frankzhangxinzhi/biomimetic-robotic-octopus/README.md

# Biomimetic Robotic Octopus

A biomimetic underwater robot using asymmetrically stiffening flexible fins for propulsion and maneuvering.

<p align="center">
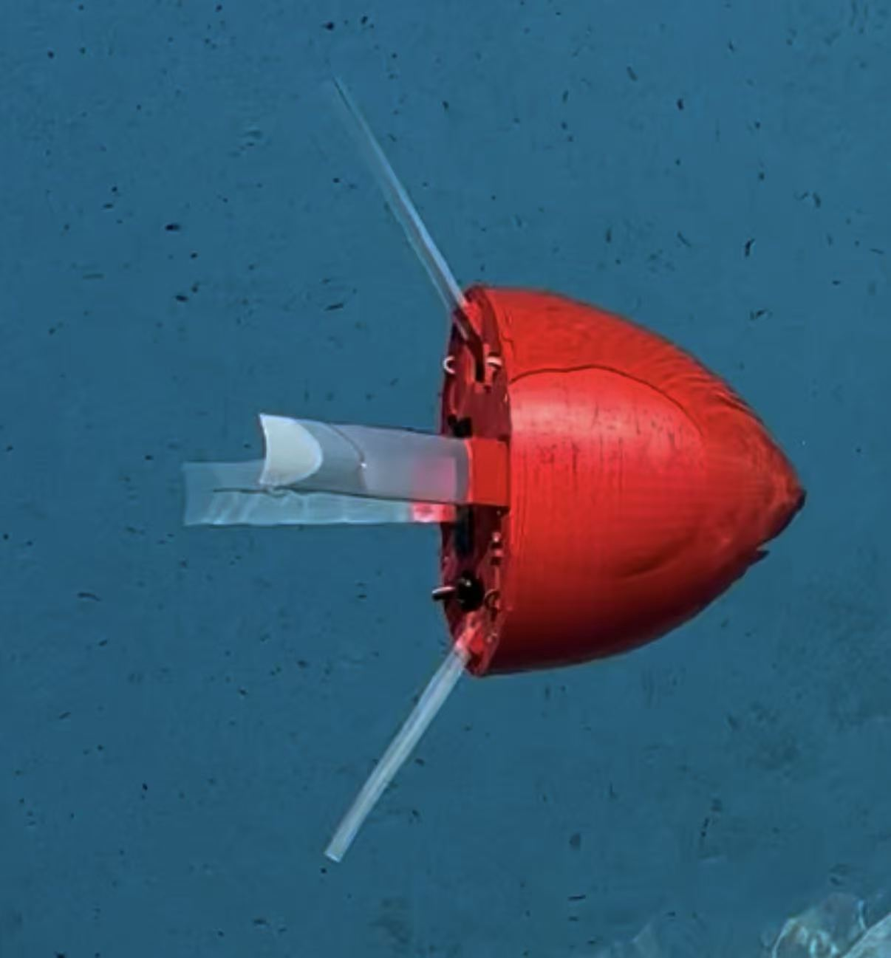
[picture p1: images/robot-pool-test.jpg]
Biomimetic robotic octopus during pool testing
  
</p>

## Overview

This project was developed by a three-person USC engineering team to design, manufacture, and test a compact biomimetic underwater robot. Four servo-actuated flexible fins use asymmetric stiffening to generate propulsion.

Pool trials demonstrated fin-driven propulsion and a basic turning response. The report extrapolated fitted swimming trajectories to assess stability over 3 m of travel. Three fin-deactivation trials reported a 180-degree turning response of 5.5 ± 0.4 seconds. Closed-loop heading control and trajectory tracking remained future work.

## Explore the Project

| Project area | Files and documentation |
| --- | --- |
| AME 441a: fin characterization | [Original MATLAB analysis, dual-servo firmware and experimental data](research/fin-characterization) |
| AME 441b: mechanical design | [SolidWorks assembly and STEP model](hardware/mechanical) |
| AME 441b: electronics | [KiCad schematic, PCB layout and connector mapping](hardware/pcb) |
| AME 441b: robot firmware | [Four-servo BLE control and operating sequence](software/firmware/robot_control_ble) |
| AME 441b: pool testing | [Swimming and turning results, figures and recovered Tracker files](testing/pool-tests) |

## My Contributions

- Independently designed the custom PCB in KiCad and completed system wiring and circuit debugging.
- Led the SolidWorks mechanical design and independently performed the buoyancy calculations.
- Collaborated on IMU data acquisition and MATLAB-based data visualization.
- Independently completed waterproofing integration and electrical system validation.
- Co-developed the Arduino-based control software for four servo-actuated fins.
- Led pool testing and analysis of straight-swimming and turning performance.

## Earlier Research Phase: AME 441a

Before the robotic octopus integration, the first semester investigated tunable-stiffness fins using a load-cell water-tank test fixture. Four materials and multiple fin lengths were evaluated through MATLAB data acquisition and analysis. Nylon reached a measured thrust-to-drag ratio of approximately 2.70 at 125 mm.

[View the recovered Arduino firmware, original MATLAB code, saved results, experiment documentation and data inventory.](research/fin-characterization)

[Download the AME 441a experimental data archive (156 CSV files).](https://github.com/frankzhangxinzhi/biomimetic-robotic-octopus/releases/tag/441a-data-v1)

This earlier four-person research phase is documented separately from the three-person AME 441b robot described on this page.

## System Design

<p align="center">
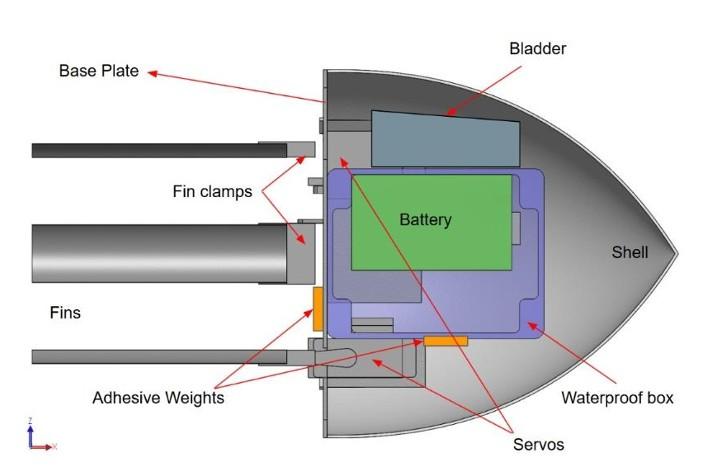
[picture p2: images/system-cross-section.jpg]
Cross-sectional SolidWorks model of the robotic octopus
  
</p>

<p align="center"><em>Cross-sectional SolidWorks model showing the mechanical and electrical system layout.</em></p>

[View the complete SolidWorks source assembly and neutral STEP model.](hardware/mechanical)

### Mechanical Architecture

- Overall vehicle length: 320 mm, including the flexible fins.
- Base plate diameter: 200 mm.
- SolidWorks mass-property and buoyancy models were used to position the center of buoyancy approximately 14 mm above the center of mass for passive restoring stability.
- Four servo-actuated flexible fins generate thrust through asymmetric stiffening and buckling.

### Electrical and Control System

- Arduino Nano RP2040 Connect with an onboard IMU for orientation sensing.
- Four high-torque servo motors actuate the flexible fins.
- Custom PCB designed in KiCad to fit inside the limited waterproof enclosure.
- PCB power traces use a 2 mm width designed to carry at least 4 A.
- Two 7.2 V Ni-MH battery packs divide the electrical load between the Arduino and four servos.
- Electronics are housed inside an IP67-rated junction box with sealed cable penetrations.

## Testing and Results

Pool testing was recorded using multiple GoPro cameras. The robot's position was manually tracked in Physics Tracker and exported for trajectory analysis.

- Conducted pool-swimming trials and used fitted motion trends to estimate performance over 3 m of travel.
- The report projected vertical displacement of 0.44-0.79 m over 3 m of travel, demonstrating the need for active stability control. This range was extrapolated from fitted motion trends.
- Characterized the open-loop turning response by deactivating one fin: a 180-degree reorientation took 5.5 ± 0.4 seconds across three trials.
- IMU acceleration and gyroscope data were evaluated for future pitch, roll, and yaw feedback control.

The turning trials demonstrated a basic response to asymmetric fin actuation. Precise commanded-heading control, closed-loop stabilization, and trajectory tracking were not implemented. Testing was limited to three trials per swimming method, and only the 1:1 recovery-to-power-stroke time ratio was tested.

[View the swimming/turning test methods, reported figures and recovered Tracker projects.](testing/pool-tests)

## Engineering Lessons

- Manufacturer-rated waterproof components should be independently pressure- or immersion-tested before system integration.
- PCB trace width must be determined from the maximum expected current before completing the layout.
- Passive buoyancy and mass distribution improve stability but are not sufficient to reject disturbances during swimming.
- IMU-based closed-loop control could vary individual fin actuation to correct trajectory deviations.

## Tools and Technologies

- **Mechanical:** SolidWorks, 3D printing, buoyancy and mass-property analysis
- **Electrical:** KiCad, custom PCB design, Arduino Nano RP2040 Connect, IMU sensing
- **Software and Analysis:** Arduino C/C++, MATLAB, Microsoft Excel, Physics Tracker
- **Testing:** Pool testing, GoPro video capture, trajectory tracking, electrical validation

## Repository Structure

```text
.
├── hardware/
│   ├── mechanical/
│   │   ├── solidworks/               # SolidWorks assembly and referenced part files
│   │   ├── step/                     # Software-independent STEP assembly
│   │   └── README.md                 # Mechanical design documentation
│   └── pcb/                          # KiCad schematic, PCB layout, and project files
├── software/
│   └── firmware/
│       ├── robot_control_ble/        # Arduino BLE servo-control firmware
│       └── archive/                  # Earlier four-servo firmware without BLE
├── research/
│   └── fin-characterization/          # AME 441a original MATLAB work, results, and data inventory
├── testing/
│   └── pool-tests/                    # Swimming/turning methods, report figures, and original Tracker files
├── images/                           # Prototype, CAD, and system-design images
├── .gitignore
└── README.md
```

## Future Work

- Implement closed-loop IMU feedback for pitch, roll, and yaw correction.
- Replace the servos with independently validated waterproof actuators.
- Conduct additional trials across multiple fin frequencies and control inputs.
- Improve trajectory tracking and automate experimental data processing.

## Team

Developed as a three-person USC AME 441b senior design project by Frank Zhang, Adrien Ramos, and Kaleigh Ray.

This repository focuses on Frank Zhang's PCB design, electrical integration, mechanical design, buoyancy analysis, sensing, and testing contributions.
