frankzhangxinzhi/biomimetic-robotic-octopus/testing/pool-tests/figures/reported-3m-horizontal-projection.png

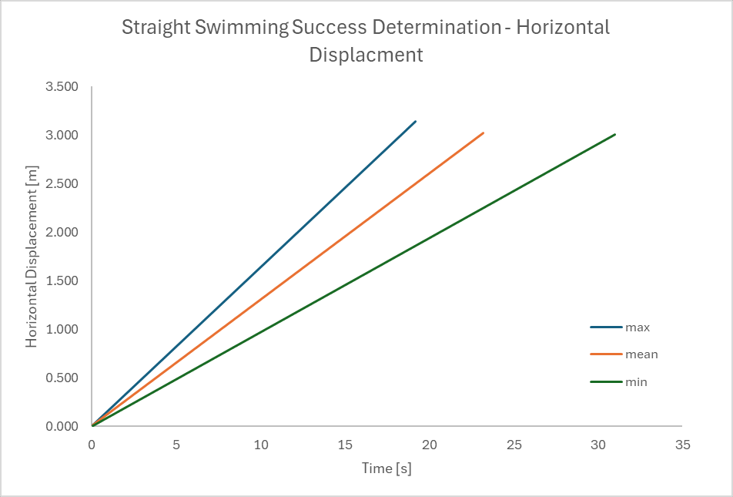
testing/pool-tests/figures/reported-3m-horizontal-projection.png
