frankzhangxinzhi/biomimetic-robotic-octopus/testing/pool-tests/figures/straight-swimming-reported-vertical.png

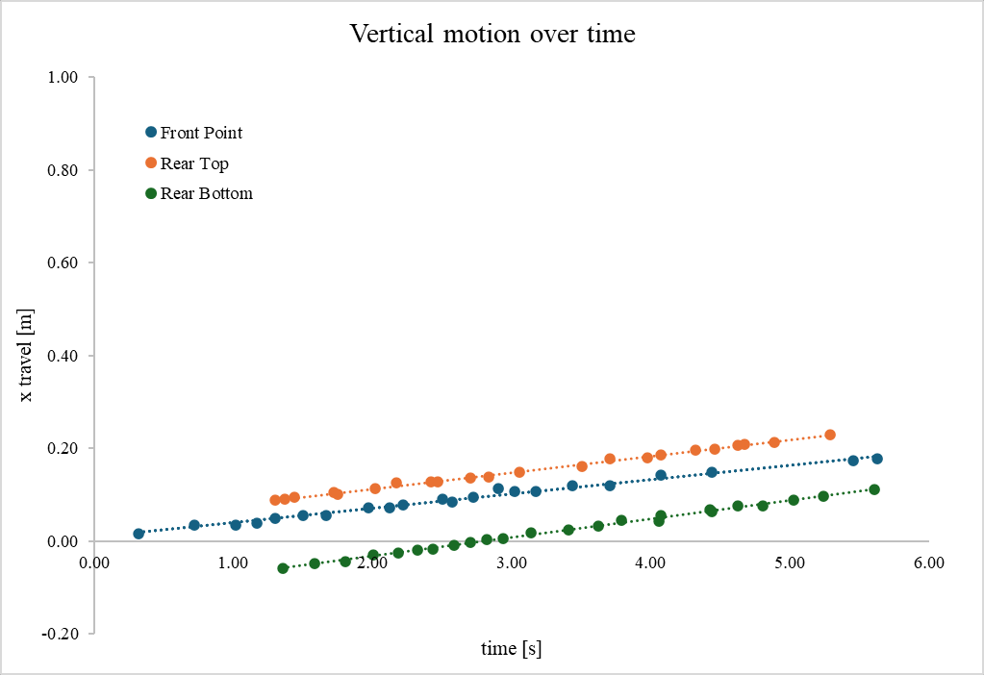
testing/pool-tests/figures/straight-swimming-reported-vertical.png
