frankzhangxinzhi/biomimetic-robotic-octopus/testing/pool-tests/figures/turning-reported-time-trace.png

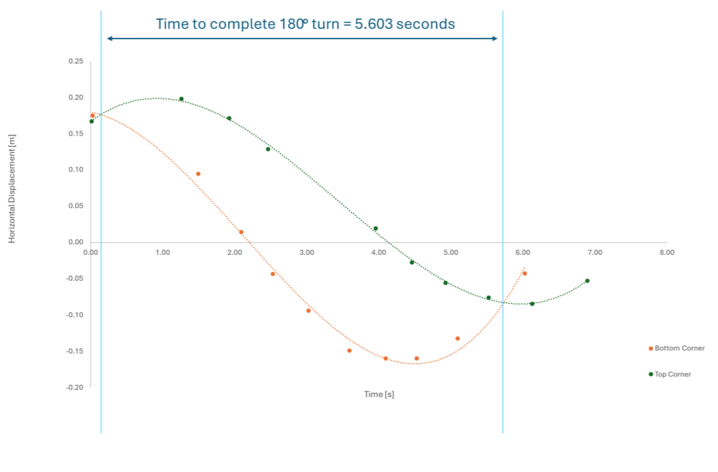
testing/pool-tests/figures/turning-reported-time-trace.png
