frankzhangxinzhi/biomimetic-robotic-octopus/hardware/mechanical/step/RoboOctoV4_Assembly.STEP

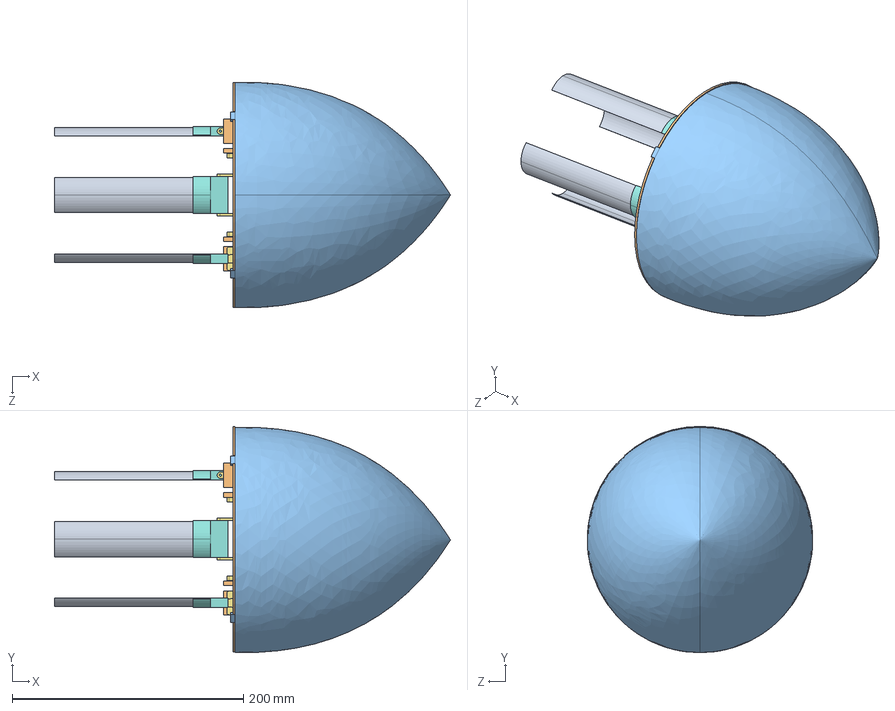
[picture p7: CAD file, 2026-10-29]
hardware/mechanical/step/RoboOctoV4_Assembly.STEP
342.6 x 195.8 x 195.0 mm
BatteryNiMH x 2
ElectroBox115_90_55
converter x 4
wireConnectors
EboxLid
arduinoBlock x 2
servoWithHorn x 4
Clamp x 4
fin x 4
BottomPlate
AdhesiveWeights - Copy (2)
