frankzhangxinzhi/biomimetic-robotic-octopus/hardware/mechanical/solidworks/RoboOctoV4.SLDASM

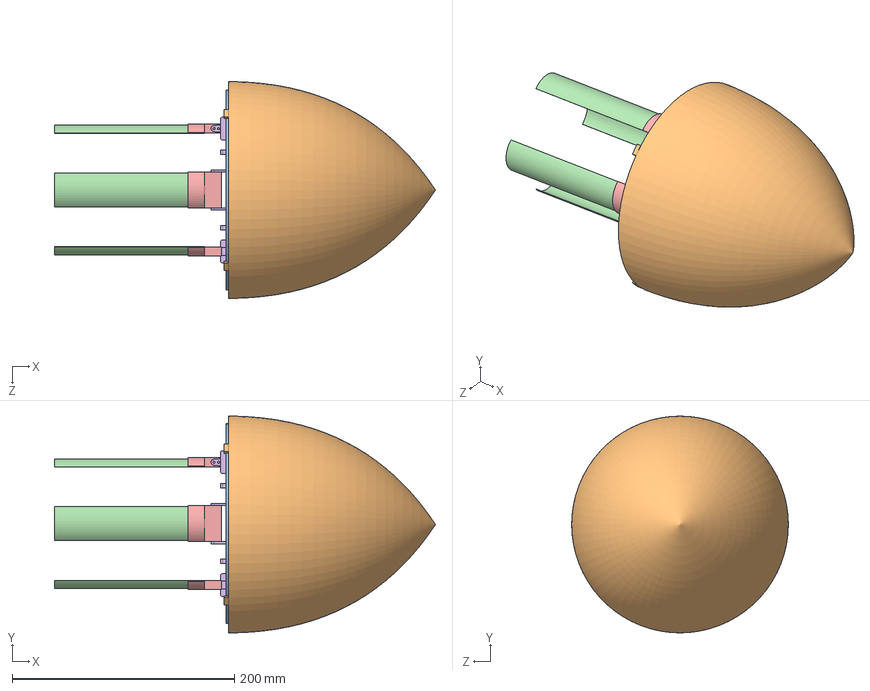
[picture p8: CAD file, 2026-10-29]
hardware/mechanical/solidworks/RoboOctoV4.SLDASM
342.7 x 195.0 x 195.0 mm
BatteryNiMH x 2
ElectroBox115_90_55
converter x 4
wireConnectors
EboxLid
arduinoBlock x 2
servoWithHorn x 4
Clamp x 4
fin x 4
BottomPlate
AdhesiveWeights - Copy (2)
