frankzhangxinzhi/biomimetic-robotic-octopus/hardware/mechanical/solidworks/Assem_electronics.SLDASM

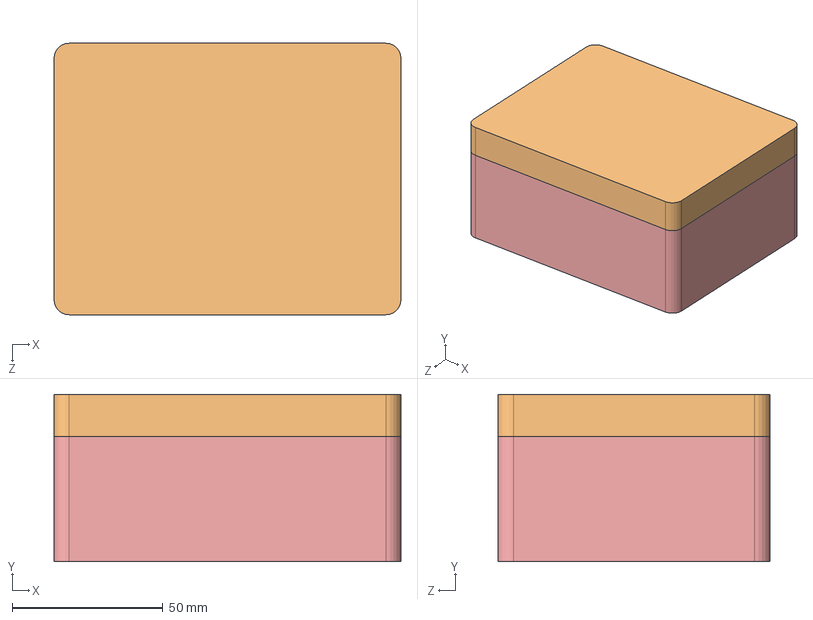
[picture p9: CAD file, 2026-10-29]
hardware/mechanical/solidworks/Assem_electronics.SLDASM
115.0 x 55.5 x 90.0 mm
BatteryNiMH x 2
ElectroBox115_90_55
converter x 4
wireConnectors
EboxLid
arduinoBlock x 2
