frankzhangxinzhi/biomimetic-robotic-octopus/hardware/mechanical/solidworks/servoWithHorn.SLDPRT

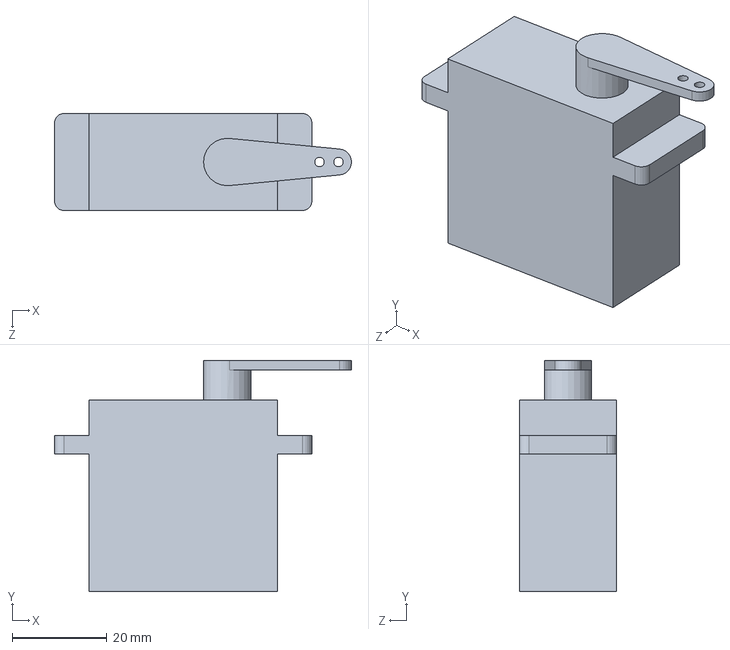
[picture p10: CAD file, 2026-10-29]
hardware/mechanical/solidworks/servoWithHorn.SLDPRT
62.7 x 48.8 x 20.5 mm
