frankzhangxinzhi/biomimetic-robotic-octopus/hardware/mechanical/solidworks/EboxLid.SLDPRT

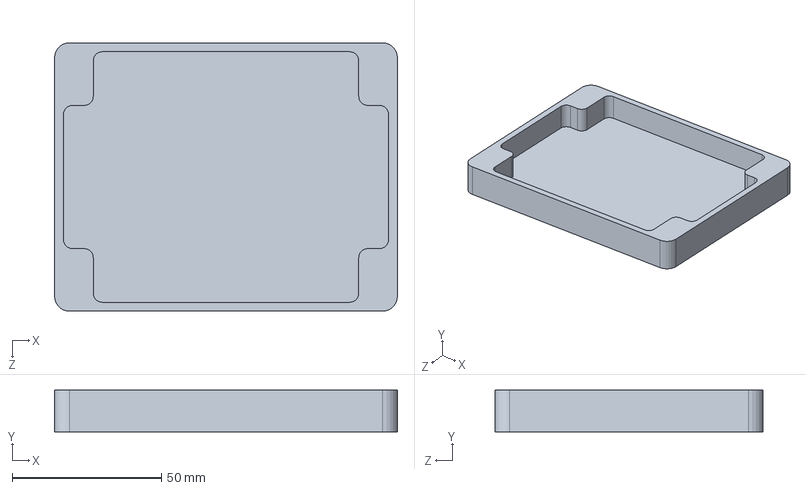
[picture p11: CAD file, 2026-10-29]
hardware/mechanical/solidworks/EboxLid.SLDPRT
115.0 x 14.0 x 90.0 mm
