frankzhangxinzhi/biomimetic-robotic-octopus/hardware/mechanical/solidworks/converter.SLDPRT

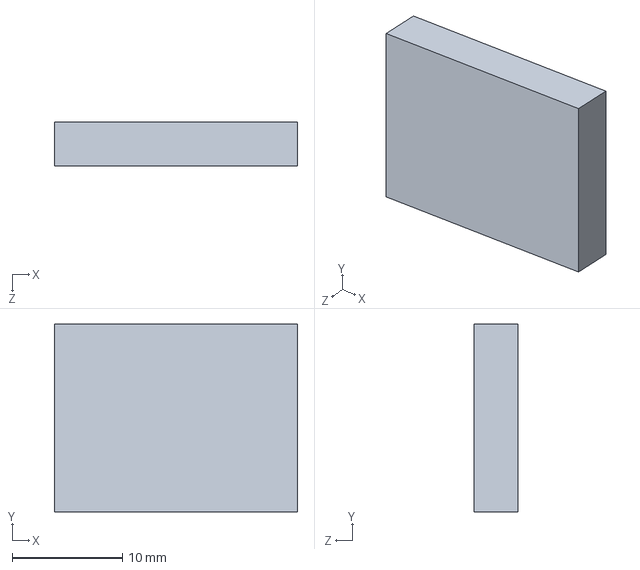
[picture p12: CAD file, 2026-10-29]
hardware/mechanical/solidworks/converter.SLDPRT
22.0 x 17.0 x 4.00 mm
