frankzhangxinzhi/biomimetic-robotic-octopus/hardware/mechanical/solidworks/ElectroBox115_90_55.SLDPRT

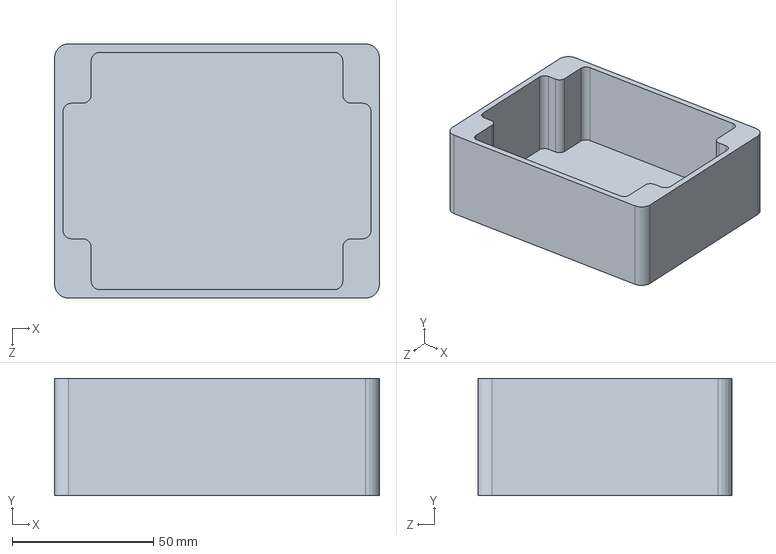
[picture p13: CAD file, 2026-10-29]
hardware/mechanical/solidworks/ElectroBox115_90_55.SLDPRT
115.0 x 41.5 x 90.0 mm
