frankzhangxinzhi/biomimetic-robotic-octopus/hardware/mechanical/solidworks/fin.SLDPRT

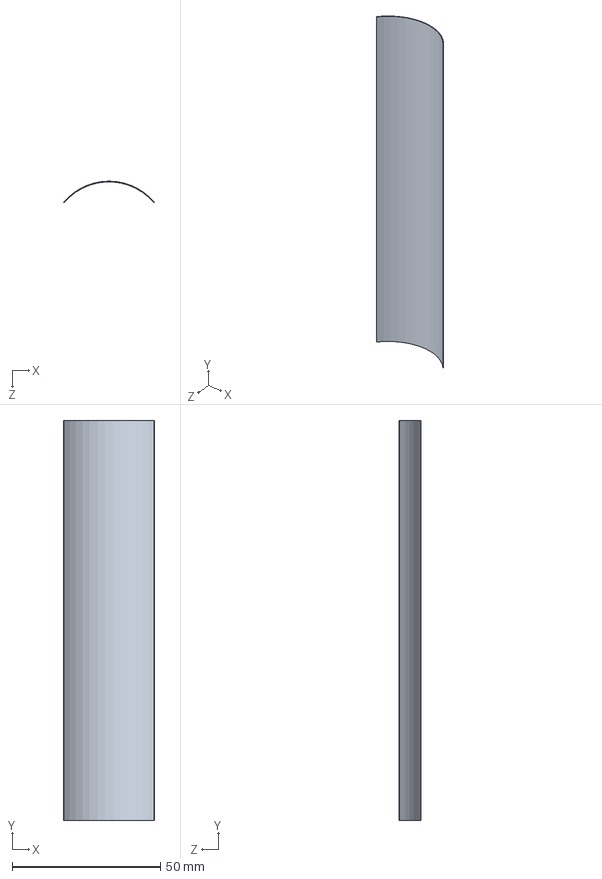
[picture p14: CAD file, 2026-10-29]
hardware/mechanical/solidworks/fin.SLDPRT
30.7 x 135.0 x 7.34 mm
