frankzhangxinzhi/biomimetic-robotic-octopus/hardware/mechanical/solidworks/BatteryNiMH.SLDPRT

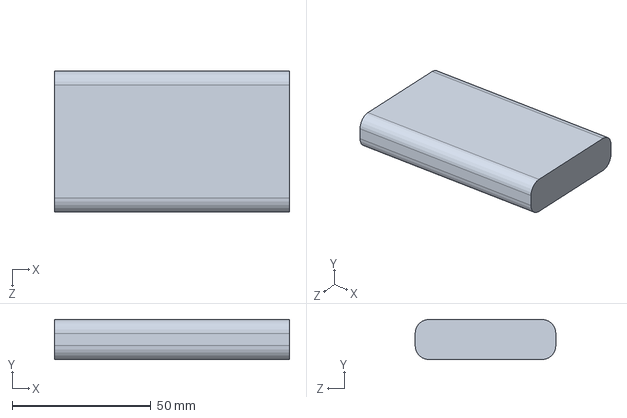
[picture p15: CAD file, 2026-10-29]
hardware/mechanical/solidworks/BatteryNiMH.SLDPRT
84.8 x 14.5 x 50.8 mm
