frankzhangxinzhi/biomimetic-robotic-octopus/hardware/mechanical/solidworks/Clamp.SLDPRT

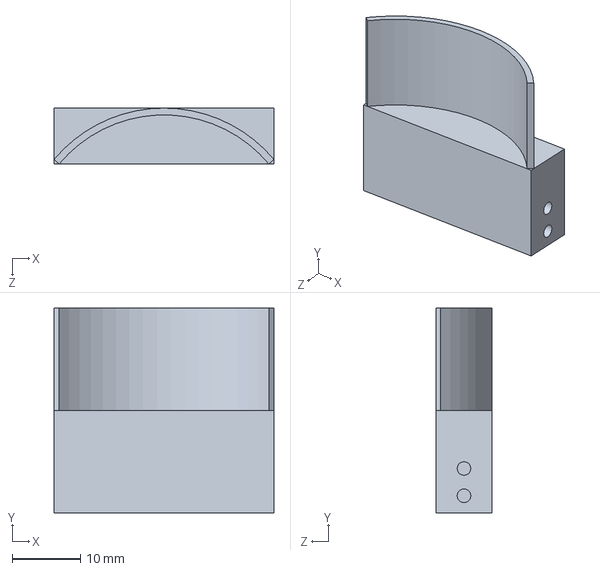
[picture p16: CAD file, 2026-10-29]
hardware/mechanical/solidworks/Clamp.SLDPRT
32.2 x 30.0 x 8.18 mm
