frankzhangxinzhi/biomimetic-robotic-octopus/hardware/mechanical/solidworks/arduinoBlock.SLDPRT

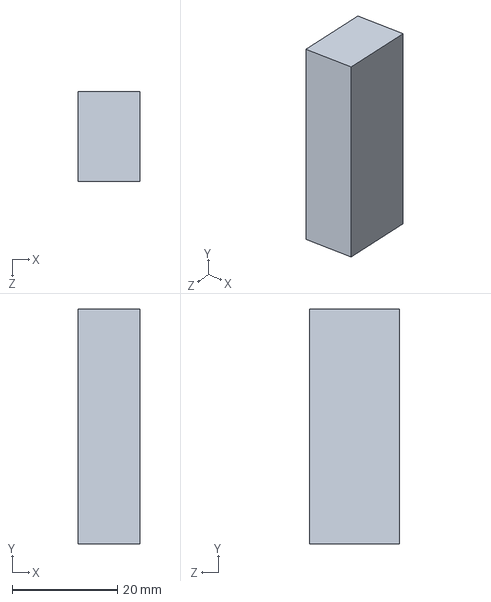
[picture p17: CAD file, 2026-10-29]
hardware/mechanical/solidworks/arduinoBlock.SLDPRT
11.7 x 44.7 x 17.2 mm
