frankzhangxinzhi/biomimetic-robotic-octopus/hardware/mechanical/solidworks/wireConnectors.SLDPRT

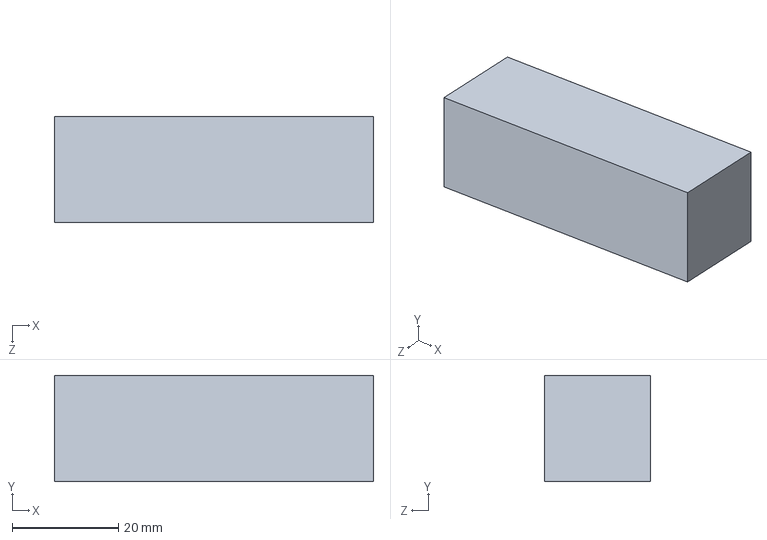
[picture p18: CAD file, 2026-10-29]
hardware/mechanical/solidworks/wireConnectors.SLDPRT
60.0 x 20.0 x 20.0 mm
