frankzhangxinzhi/biomimetic-robotic-octopus/hardware/mechanical/solidworks/AdhesiveWeights - Copy (2).SLDPRT

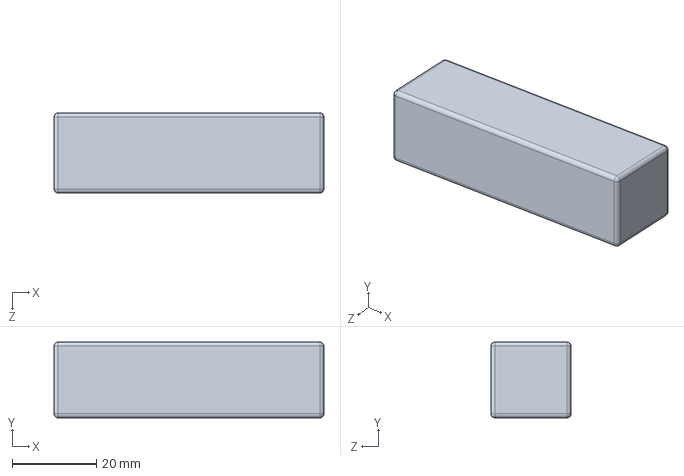
[picture p19: CAD file, 2026-10-29]
hardware/mechanical/solidworks/AdhesiveWeights - Copy (2).SLDPRT
64.0 x 18.0 x 19.0 mm
