frankzhangxinzhi/biomimetic-robotic-octopus/hardware/mechanical/solidworks/Shell.SLDPRT

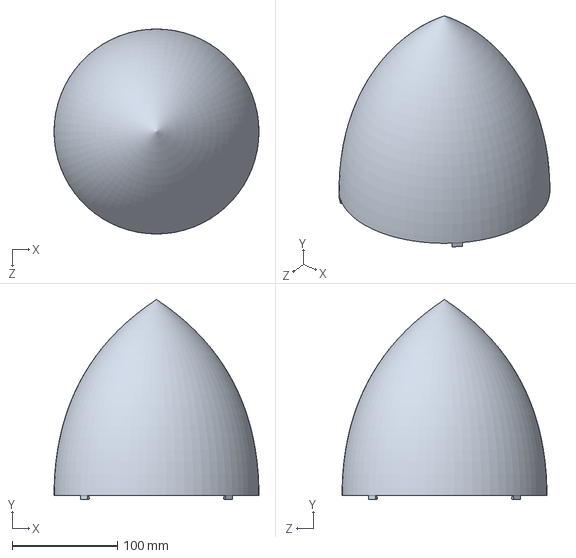
[picture p20: CAD file, 2026-10-29]
hardware/mechanical/solidworks/Shell.SLDPRT
195.0 x 190.3 x 195.0 mm
