frankzhangxinzhi/biomimetic-robotic-octopus/hardware/mechanical/solidworks/BottomPlate.SLDPRT

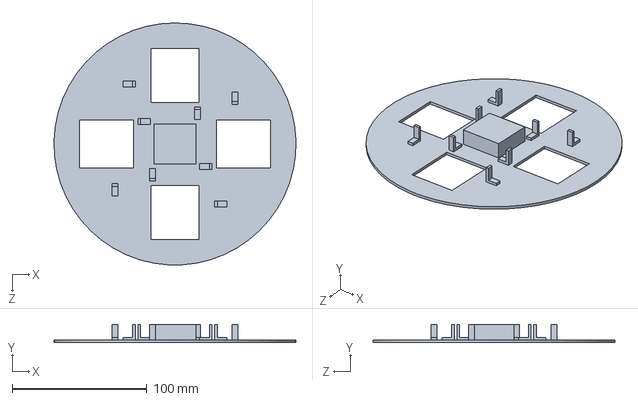
[picture p21: CAD file, 2026-10-29]
hardware/mechanical/solidworks/BottomPlate.SLDPRT
179.9 x 13.6 x 180.0 mm
