frankzhangxinzhi/biomimetic-robotic-octopus/research/fin-characterization/figures/Fvst_Nylon125mm.png

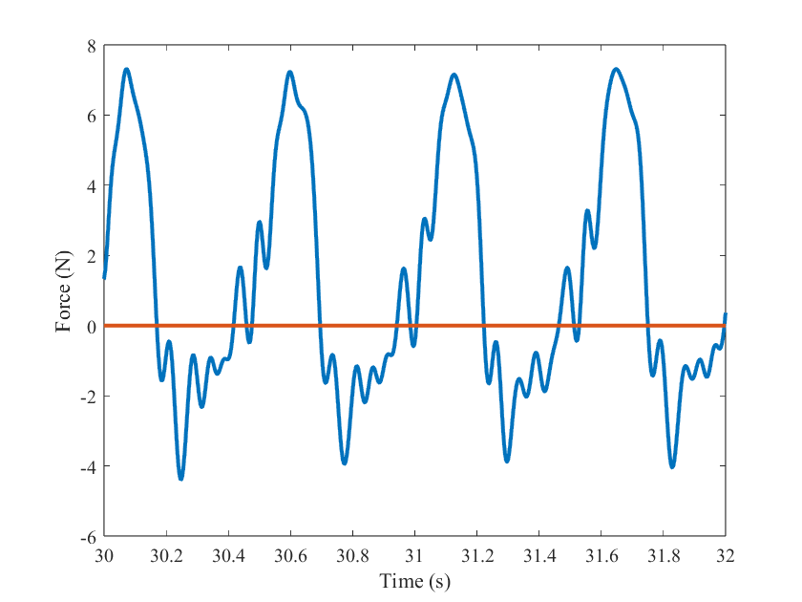
research/fin-characterization/figures/Fvst_Nylon125mm.png
