frankzhangxinzhi/biomimetic-robotic-octopus/(commit log)

2026-10-27 Add KiCad PCB design files
2026-10-27 Add BLE servo control firmware
2026-10-29 Add PCB design documentation
2026-10-29 Add mechanical CAD assembly and STEP export
2026-10-29 Add SolidWorks assembly visualization
2026-10-29 Link mechanical CAD from project README
2026-10-29 Clarify collaborative IMU contribution
